patrickmoffitt/5mp_motion_camera/docs/5MP_Motion_Camera_v1_2.jpg

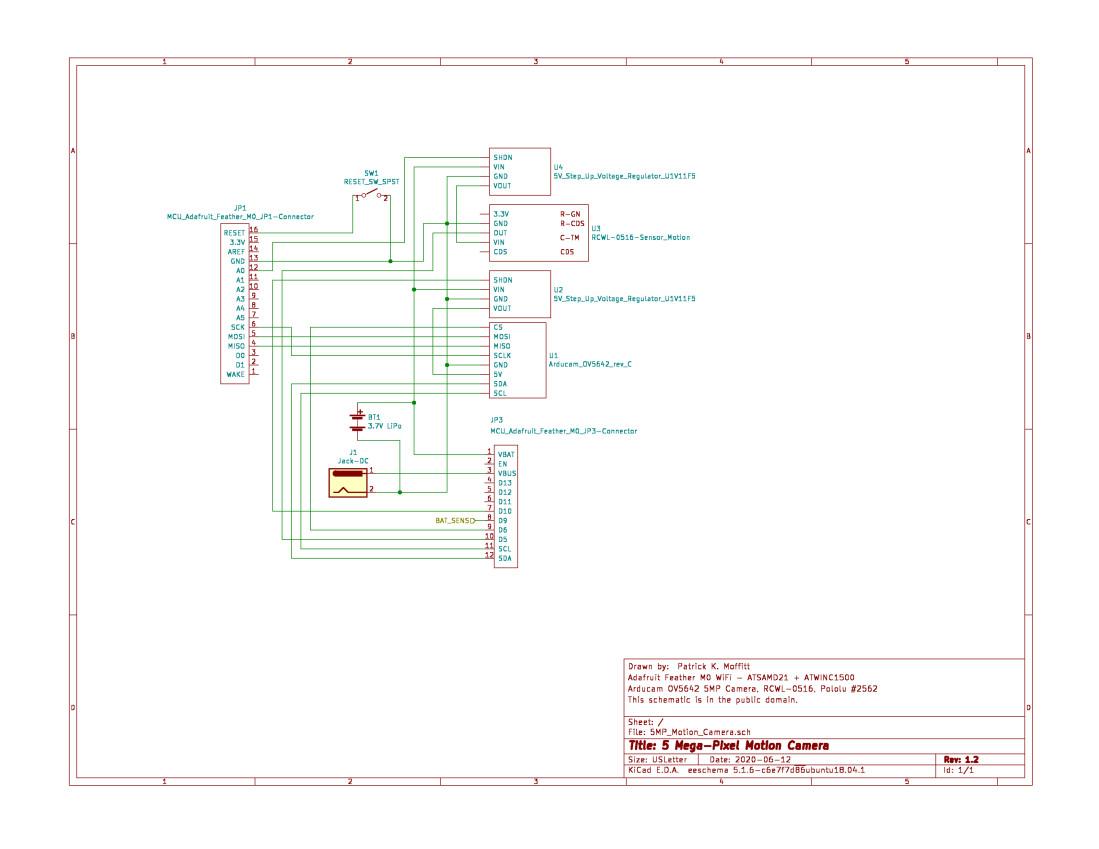
docs/5MP_Motion_Camera_v1_2.jpg
