patrickmoffitt/5mp_motion_camera/images/5MP_Motion_Camera_v1_3.pdf

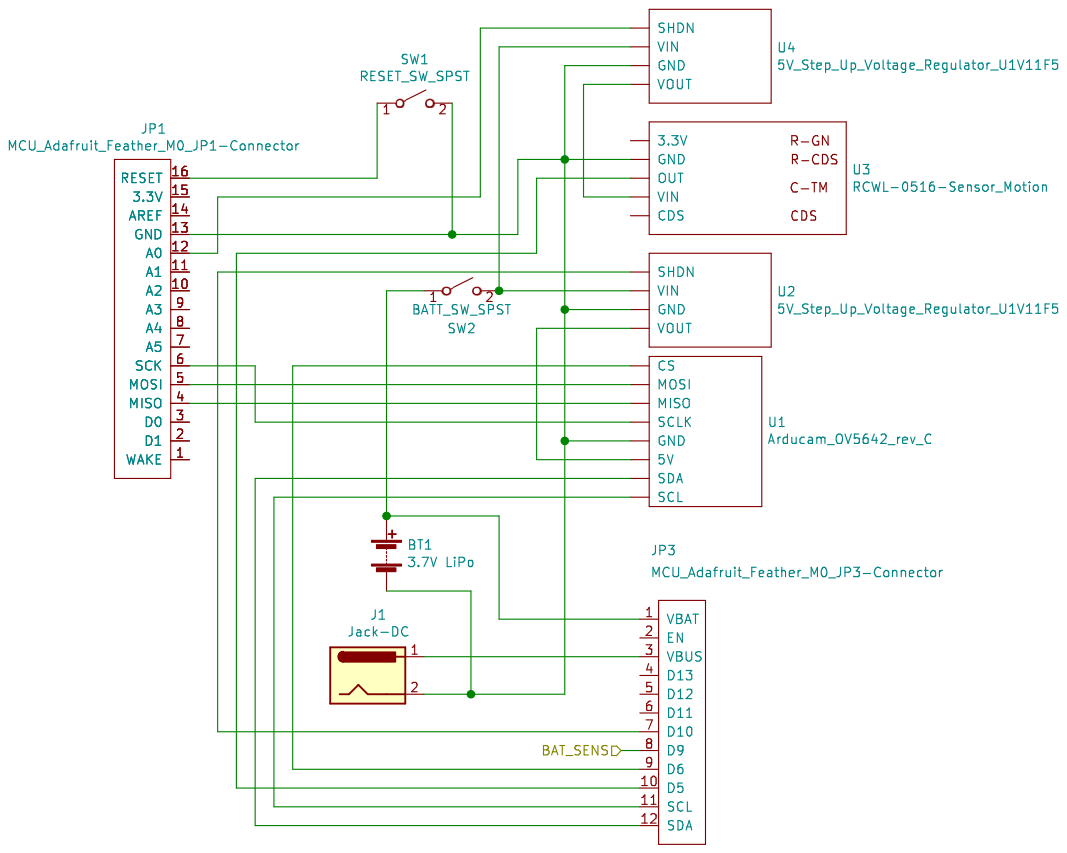
[picture p16: page 1]
