patrickmoffitt/5mp_motion_camera/images/5MP_Motion_Camera_v1_3.sch

## KiCad design images/5MP_Motion_Camera_v1_3.sch (2021-01-10)

Schematic: 5MP_Motion_Camera_v1_3.sch

Parts:
BT1: 3.7V LiPo
J1: Jack-DC
JP1: MCU_Adafruit_Feather_M0_JP1-Connector
JP3: MCU_Adafruit_Feather_M0_JP3-Connector
SW1: RESET_SW_SPST
SW2: BATT_SW_SPST
U1: Arducam_OV5642_rev_C
U2, U4: 5V_Step_Up_Voltage_Regulator_U1V11F5
U3: RCWL-0516-Sensor_Motion
