patrickmoffitt/5mp_motion_camera/(commit log)

2020-08-21 Version 1.0.0.0. Initial commit.
    [5MP_Motion_Camera.sch]
2020-12-13 Current sink should be input and pulled down.
2020-12-13 Allow Serial object to be undefined. May save a little power.
2021-01-10 Move motion sensor and add a battery switch for 5V supplies.
    [5MP_Motion_Camera_v1_3.sch]
