patrickmoffitt/5mp_motion_camera/(notices)

Notices in the files:
images/5MP_Motion_Camera_v1_3.sch:
This schematic is in the public domain.
